ethanleep/robotic-arm/README.md

# Scorebot-ER III
This is my repo for the custom controller I've been designing and assembling for the Scorebot-ER III.
All files here are to be considered a work in progress as they are far from perfect.

The main serial controlled code is robotic_arm_main.ino while the main hard coded code is Custom_movement.ino
