ethanleep/robotic-arm/box files/README.txt

These are the Autodesk Inventor part and assembly files for the controller housing
