ethanleep/robotic-arm/(list of files, cad)

Other CAD files:
box files/Modified Side.ipt
box files/basic side.ipt
box files/bottom.ipt
box files/box assembly.iam
box files/hole side.ipt
box files/other hole side.ipt
box files/top.ipt
