ethanleep/robotic-arm/Testing/README.txt

These are just miscellaneous testing files I use in debugging parts of the arm that are non-functioning or acting up.
