ethanleep/robotic-arm/Individual motor driver v2/Schematic.pdf

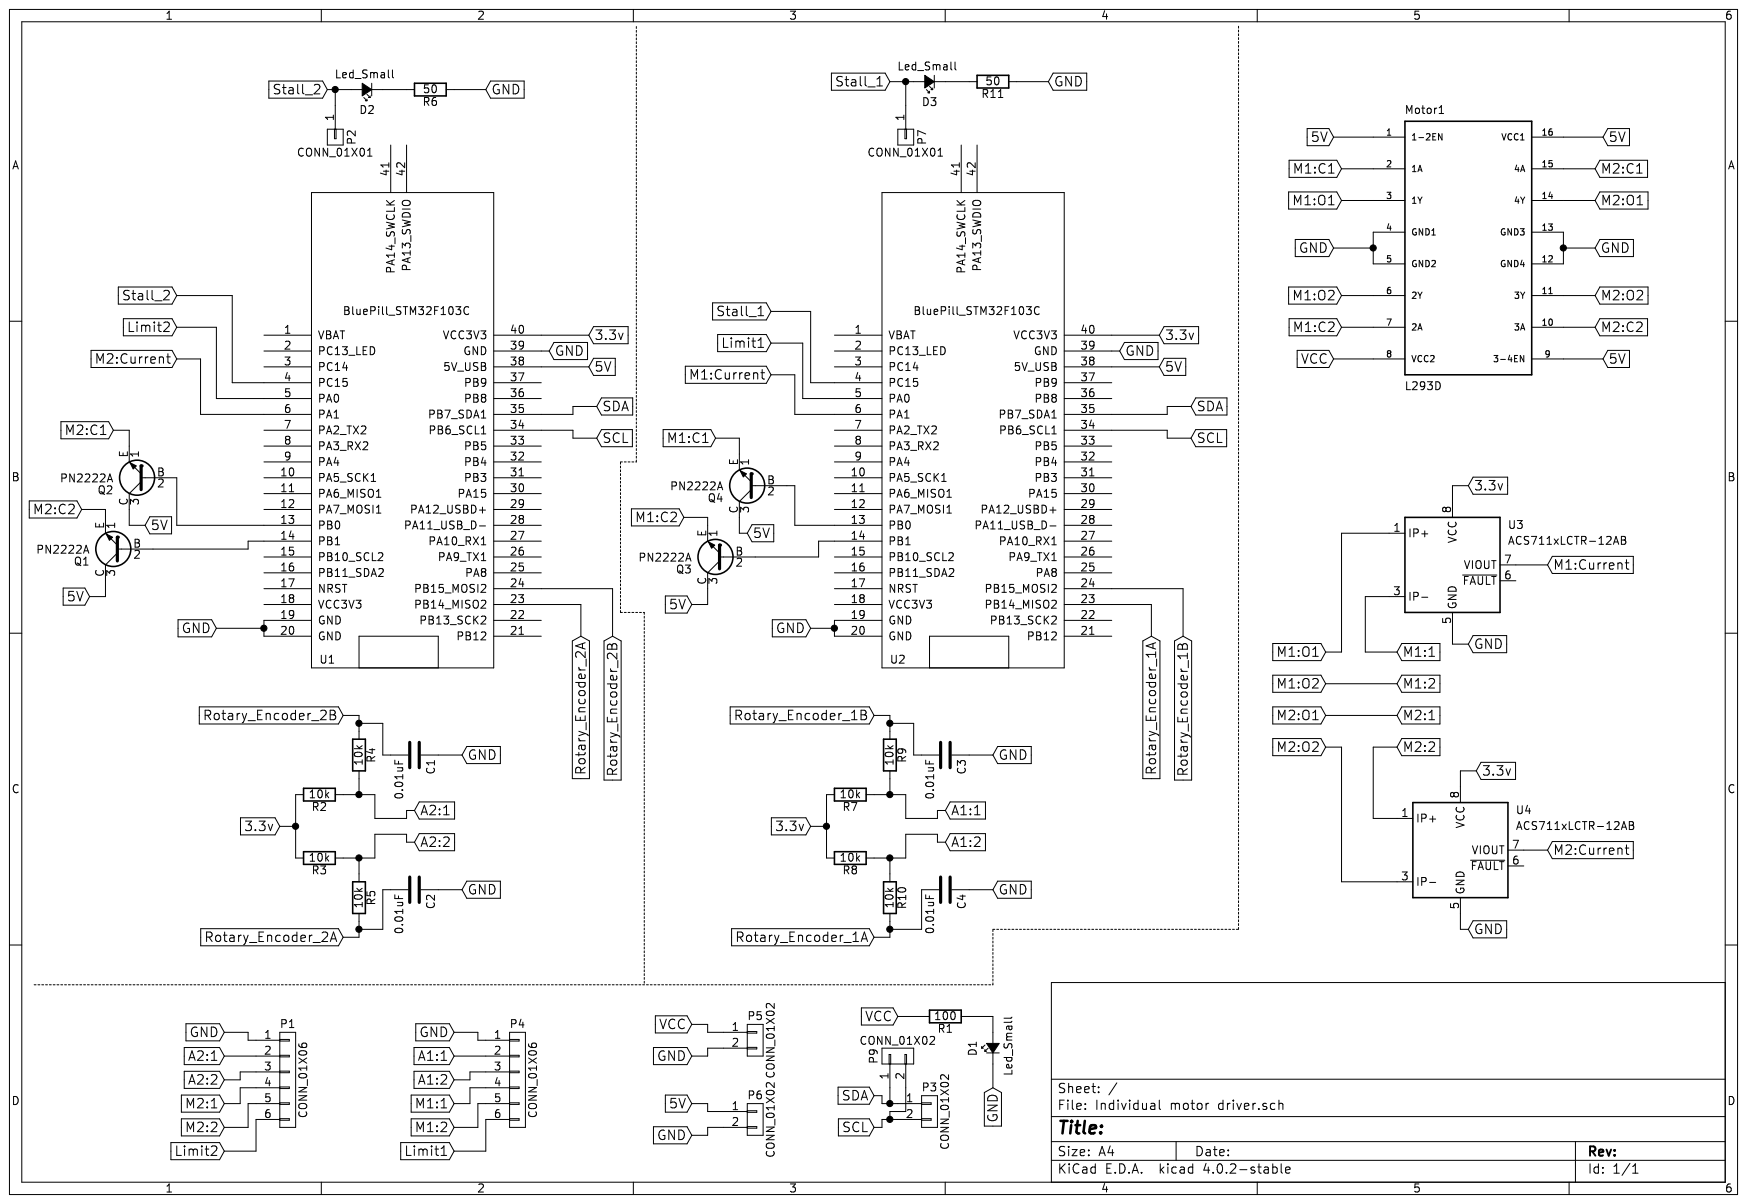
[picture p3: page 1]
