ethanleep/robotic-arm/DB50 Breakout/schematic.pdf

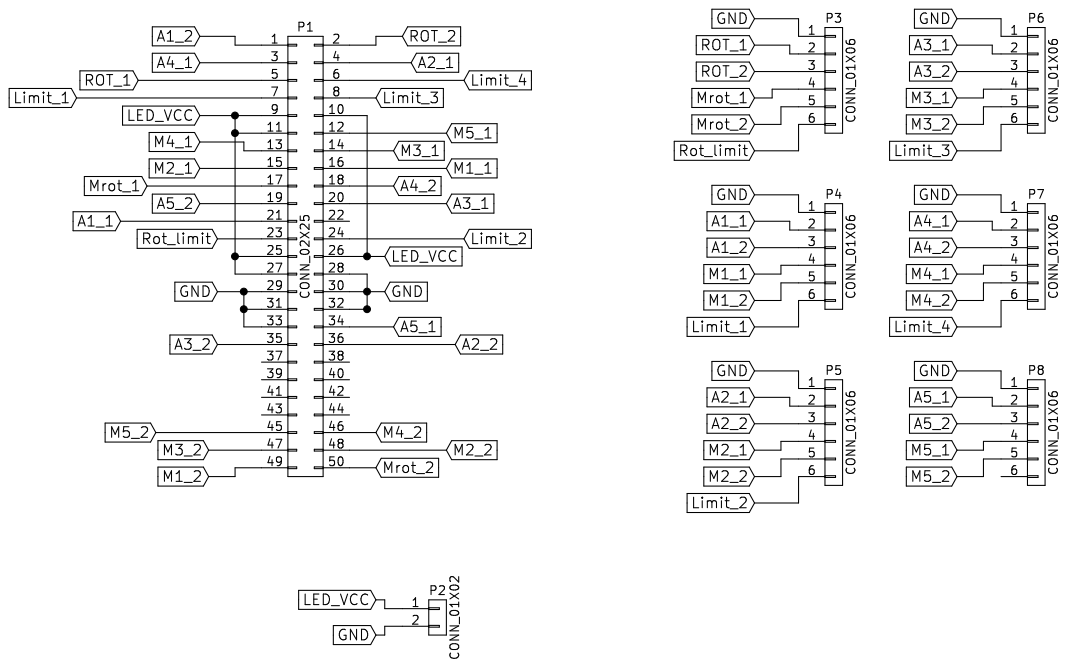
[picture p4: page 1]
