ethanleep/robotic-arm/Individual motor driver v2/Individual motor driver.kicad_pcb

## KiCad design Individual motor driver v2/Individual motor driver.kicad_pcb (2018-12-13)

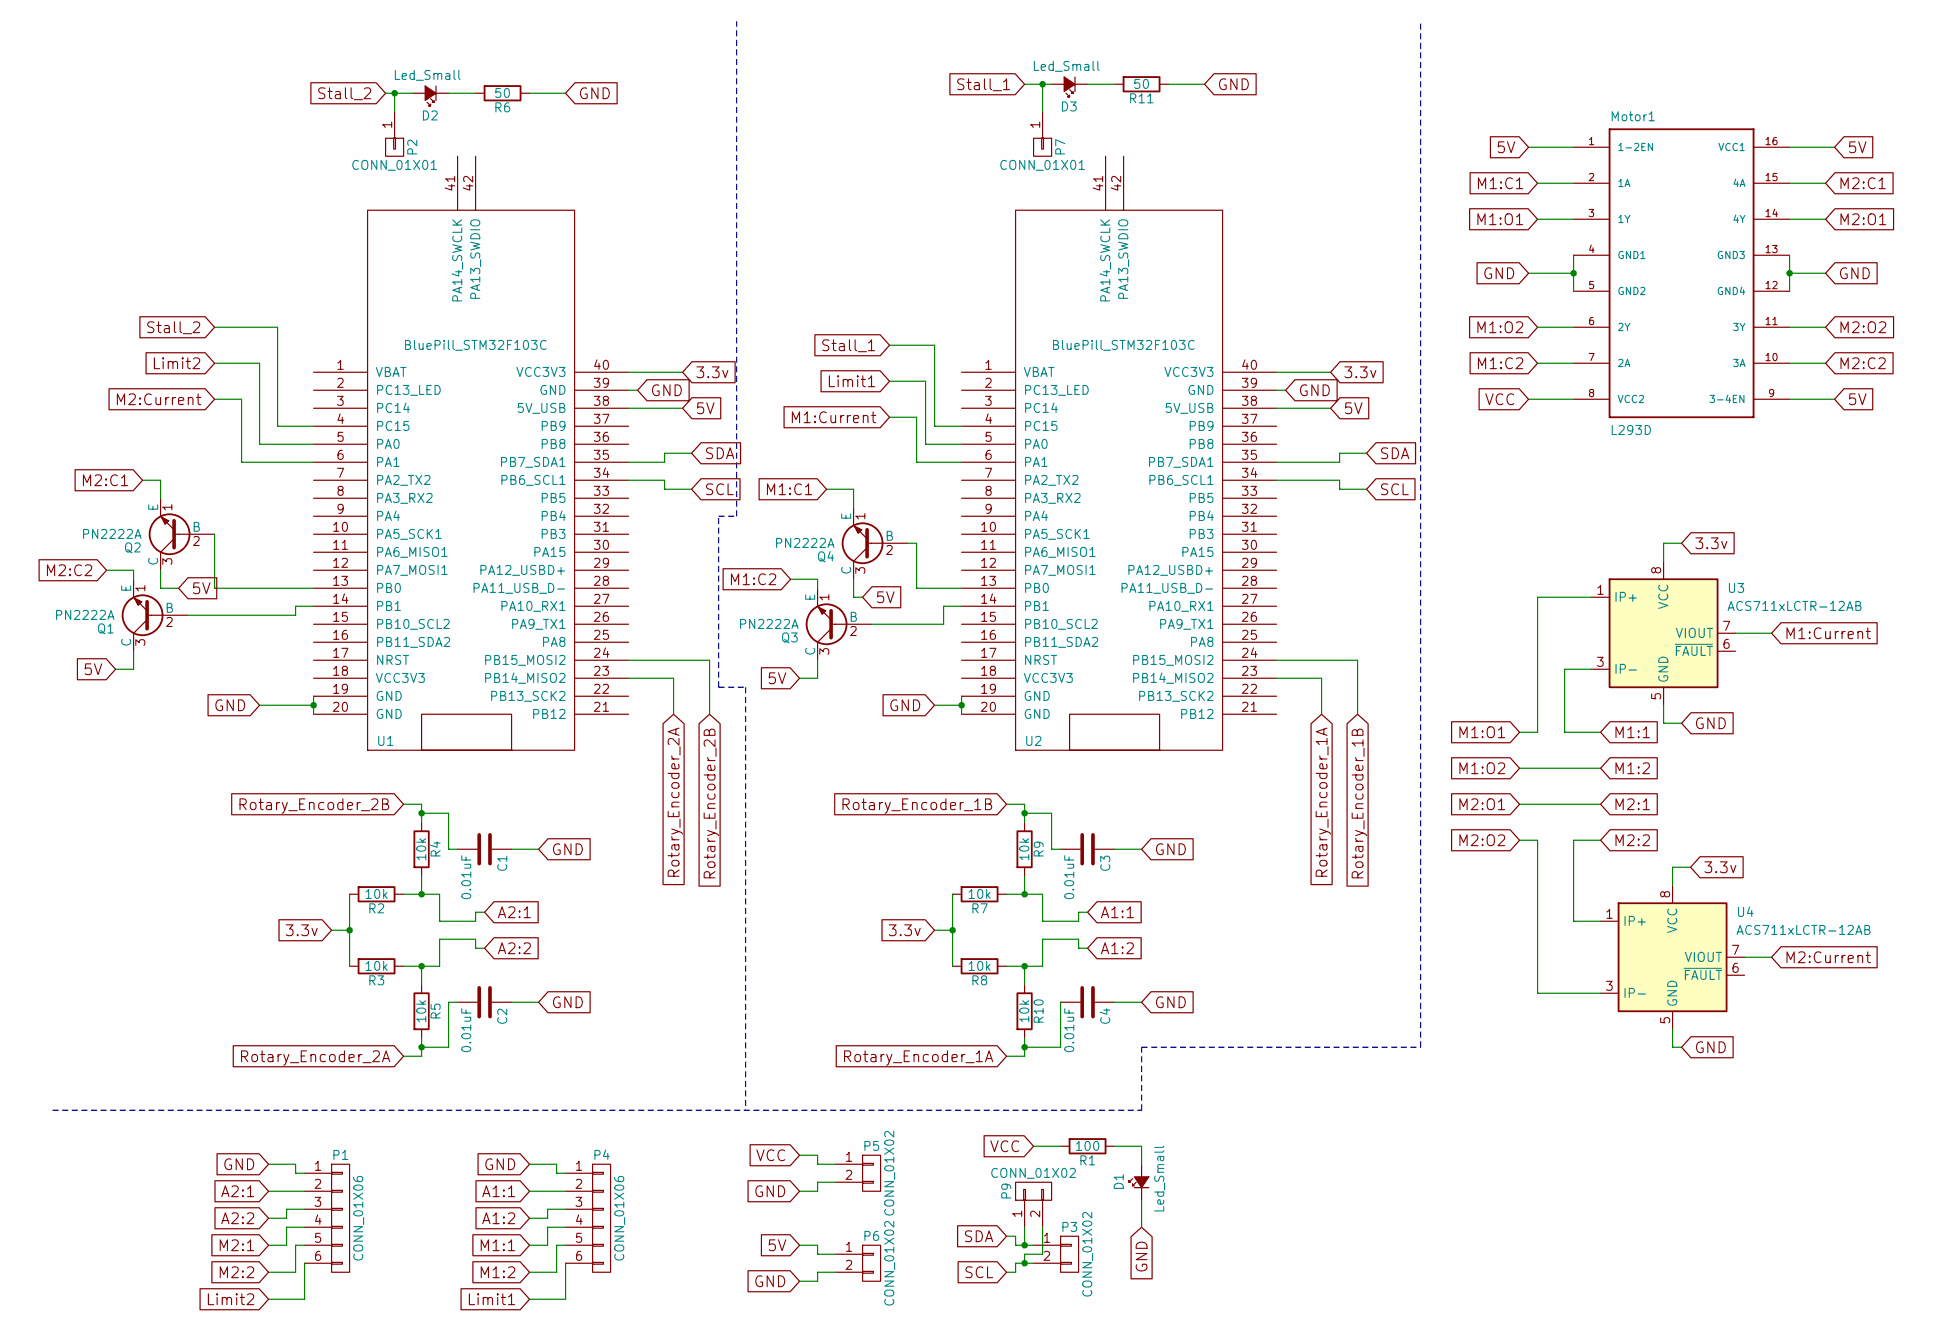
[picture p5: schematic Individual motor driver.sch]

Parts:
C1, C2, C3, C4: 0.01uF; C_Axial_L3.8mm_D2.6mm_P7.50mm_Horizontal
D1, D2, D3: Led_Small; LED_D3.0mm
Motor1: L293D; DIP-16_W7.62mm
P1, P4: CONN_01X06; PinHeader_1x06_P2.54mm_Horizontal
P2, P7: CONN_01X01; PinHeader_1x01_P2.54mm_Vertical
P3, P5, P6, P9: CONN_01X02; PinHeader_1x02_P2.54mm_Vertical
Q1, Q2, Q3, Q4: PN2222A; TO-92_Inline
R1: 100; R_Axial_DIN0207_L6.3mm_D2.5mm_P10.16mm_Horizontal
R2, R3, R4, R5, R7, R8, R9, R10: 10k; R_Axial_DIN0207_L6.3mm_D2.5mm_P10.16mm_Horizontal
R6, R11: 50; R_Axial_DIN0207_L6.3mm_D2.5mm_P10.16mm_Horizontal
U1, U2: BluePill_STM32F103C
U3, U4: ACS711xLCTR-12AB; SOIC-8_3.9x4.9mm_P1.27mm

Connections:
3.3v: R2.2, R3.2, R7.2, R8.2, U1.40 (VCC3V3), U2.40 (VCC3V3), U3.8 (VCC), U4.8 (VCC)
5V: Motor1.1 (1-2EN), Motor1.9 (3-4EN), Motor1.16 (VCC1), P6.1, Q1.3 (C), Q2.3 (C), Q3.3 (C), Q4.3 (C), U1.38 (5V_USB), U2.38 (5V_USB)
A1:1: P4.2, R7.1, R9.2
A1:2: P4.3, R8.1, R10.1
A2:1: P1.2, R2.1, R4.2
A2:2: P1.3, R3.1, R5.1
GND: C1.1, C2.1, C3.1, C4.1, D1.1 (K), Motor1.4 (GND1), Motor1.5 (GND2), Motor1.12 (GND4), Motor1.13 (GND3), P1.1, P4.1, P5.2, P6.2, R6.1, R11.1, U1.19 (GND), U1.20 (GND), U1.39 (GND), U2.19 (GND), U2.20 (GND), U2.39 (GND), U3.5 (GND), U4.5 (GND)
Limit1: P4.6, U2.5 (PA0)
Limit2: P1.6, U1.5 (PA0)
M1:1: P4.4, U3.3 (IP-), U3.4 (IP-); also elsewhere on the board
M1:2: Motor1.6 (2Y), P4.5
M1:C1: Motor1.2 (1A), Q4.1 (E)
M1:C2: Motor1.7 (2A), Q3.1 (E)
M1:Current: U2.6 (PA1), U3.7 (VIOUT)
M1:O1: Motor1.3 (1Y), U3.1 (IP+), U3.2 (IP+); also elsewhere on the board
M2:1: Motor1.14 (4Y), P1.4
M2:2: P1.5, U4.1 (IP+), U4.2 (IP+); also elsewhere on the board
M2:C1: Motor1.15 (4A), Q2.1 (E)
M2:C2: Motor1.10 (3A), Q1.1 (E)
M2:Current: U1.6 (PA1), U4.7 (VIOUT)
M2:O2: Motor1.11 (3Y), U4.3 (IP-), U4.4 (IP-); also elsewhere on the board
unnamed: D1.2 (A), R1.1
unnamed: D2.1 (K), R6.2
unnamed: D3.1 (K), R11.2
unnamed: Q1.2 (B), U1.14 (PB1)
unnamed: Q2.2 (B), U1.13 (PB0)
unnamed: Q3.2 (B), U2.14 (PB1)
unnamed: Q4.2 (B), U2.13 (PB0)
Rotary_Encoder_1A: C4.2, R10.2, U2.23 (PB14_MISO2)
Rotary_Encoder_1B: C3.2, R9.1, U2.24 (PB15_MOSI2)
Rotary_Encoder_2A: C2.2, R5.2, U1.23 (PB14_MISO2)
Rotary_Encoder_2B: C1.2, R4.1, U1.24 (PB15_MOSI2)
SCL: P3.2, P9.2, U1.34 (PB6_SCL1), U2.34 (PB6_SCL1)
SDA: P3.1, P9.1, U1.35 (PB7_SDA1), U2.35 (PB7_SDA1)
Stall_1: D3.2 (A), P7.1, U2.4 (PC15)
Stall_2: D2.2 (A), P2.1, U1.4 (PC15)
VCC: Motor1.8 (VCC2), P5.1, R1.2

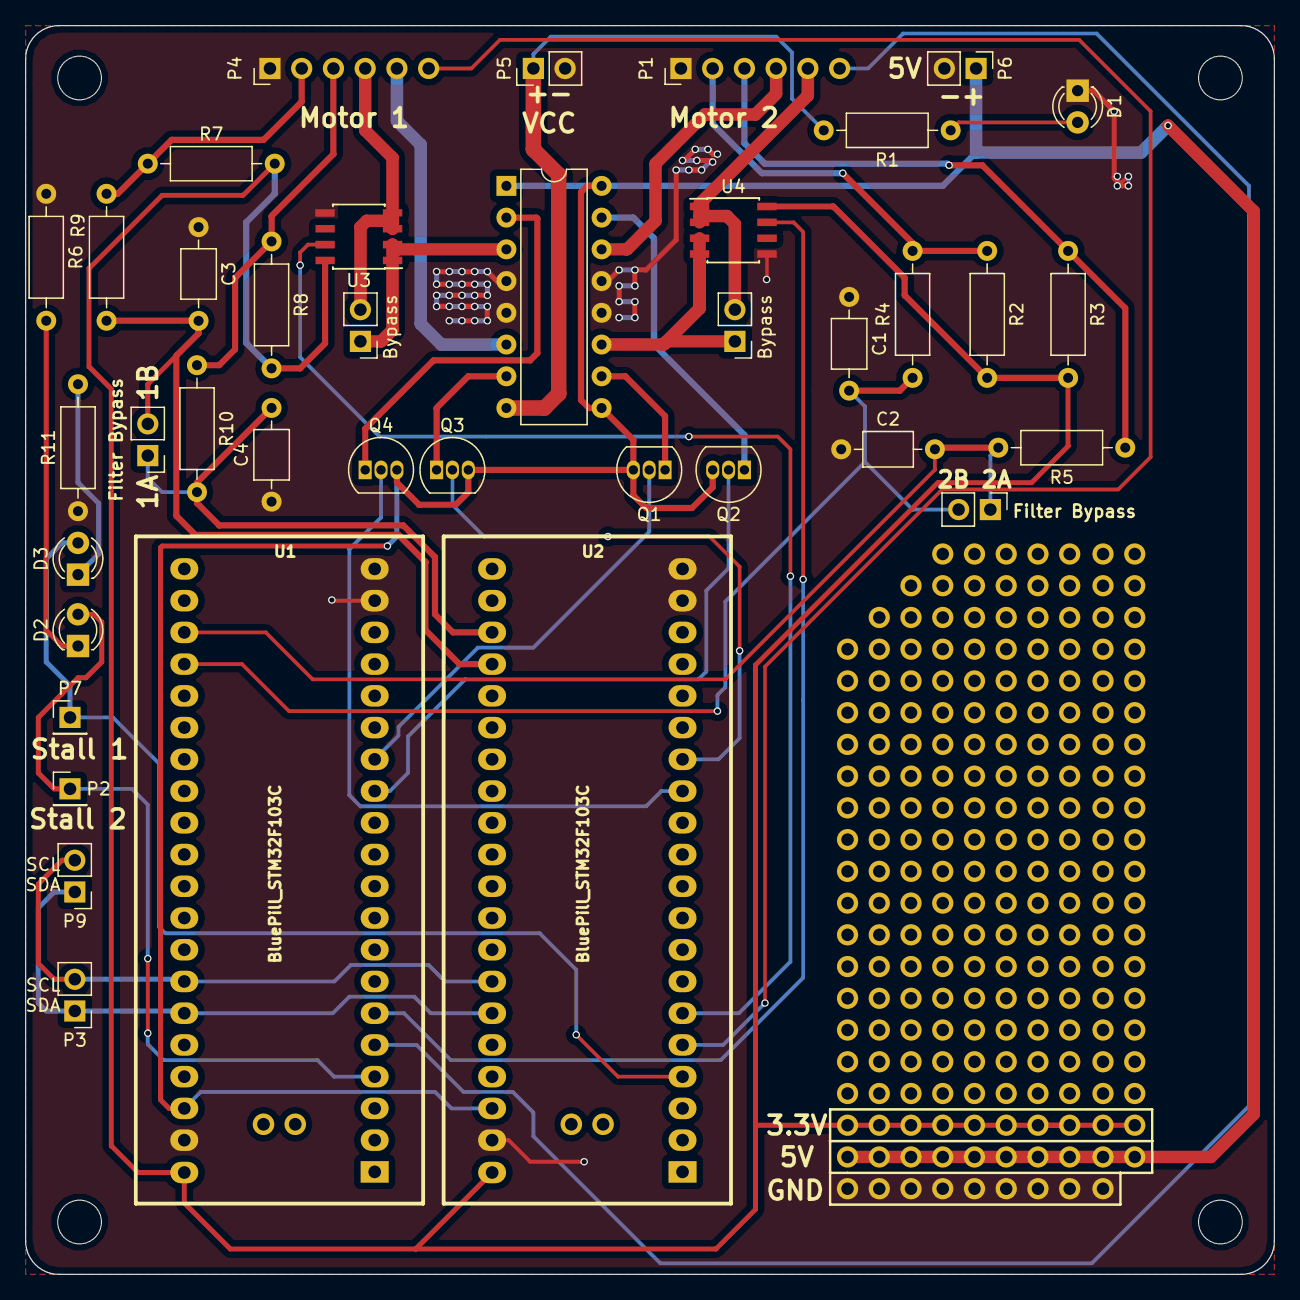
[picture p6: board Individual motor driver.kicad_pcb from above]

Board: 2 copper layers, 99.9 x 99.9 mm, 37 parts (0 on the bottom side), 37 nets.

Other parts of the board:
Bypass: PinHeader_1x02_P2.54mm_Vertical
Bypass#2: PinHeader_1x02_P2.54mm_Vertical

Their connections:
M1:1: Bypass.2; also elsewhere on the board
M1:O1: Bypass.1; also elsewhere on the board
M2:2: Bypass#2.2; also elsewhere on the board
M2:O2: Bypass#2.1; also elsewhere on the board
