ethanleep/robotic-arm/DB50 Breakout/DB50 Breakout.kicad_pcb

## KiCad design DB50 Breakout/DB50 Breakout.kicad_pcb (2018-12-11)

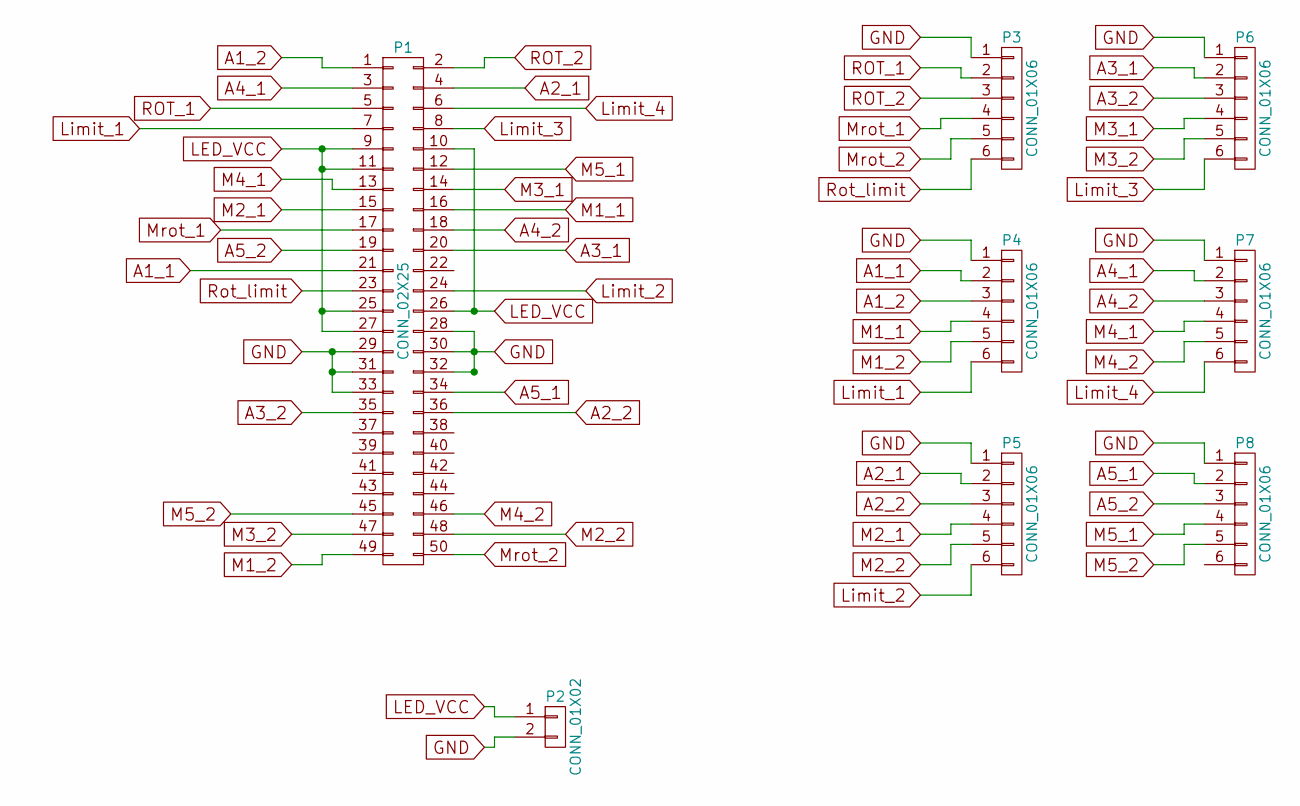
[picture p7: schematic DB50 Breakout.sch]

Parts:
P1: CONN_02X25; Dsub_50
P2: CONN_01X02; PinHeader_1x02_P2.54mm_Vertical
P3, P4, P5, P6, P7, P8: CONN_01X06; PinHeader_1x06_P2.54mm_Vertical

Connections:
A1_1: P1.21, P4.2
A1_2: P1.1, P4.3
A2_1: P1.4, P5.2
A2_2: P1.36, P5.3
A3_1: P1.20, P6.2
A3_2: P1.35, P6.3
A4_1: P1.3, P7.2
A4_2: P1.18, P7.3
A5_1: P1.34, P8.2
A5_2: P1.19, P8.3
GND: P1.28, P1.29, P1.30, P1.31, P1.32, P1.33, P2.2, P3.1, P4.1, P5.1, P6.1, P7.1, P8.1
LED_VCC: P1.9, P1.10, P1.11, P1.25, P1.26, P1.27, P2.1
Limit_1: P1.7, P4.6
Limit_2: P1.24, P5.6
Limit_3: P1.8, P6.6
Limit_4: P1.6, P7.6
M1_1: P1.16, P4.4
M1_2: P1.49, P4.5
M2_1: P1.15, P5.4
M2_2: P1.48, P5.5
M3_1: P1.14, P6.4
M3_2: P1.47, P6.5
M4_1: P1.13, P7.4
M4_2: P1.46, P7.5
M5_1: P1.12, P8.4
M5_2: P1.45, P8.5
Mrot_1: P1.17, P3.4
Mrot_2: P1.50, P3.5
ROT_1: P1.5, P3.2
ROT_2: P1.2, P3.3
Rot_limit: P1.23, P3.6

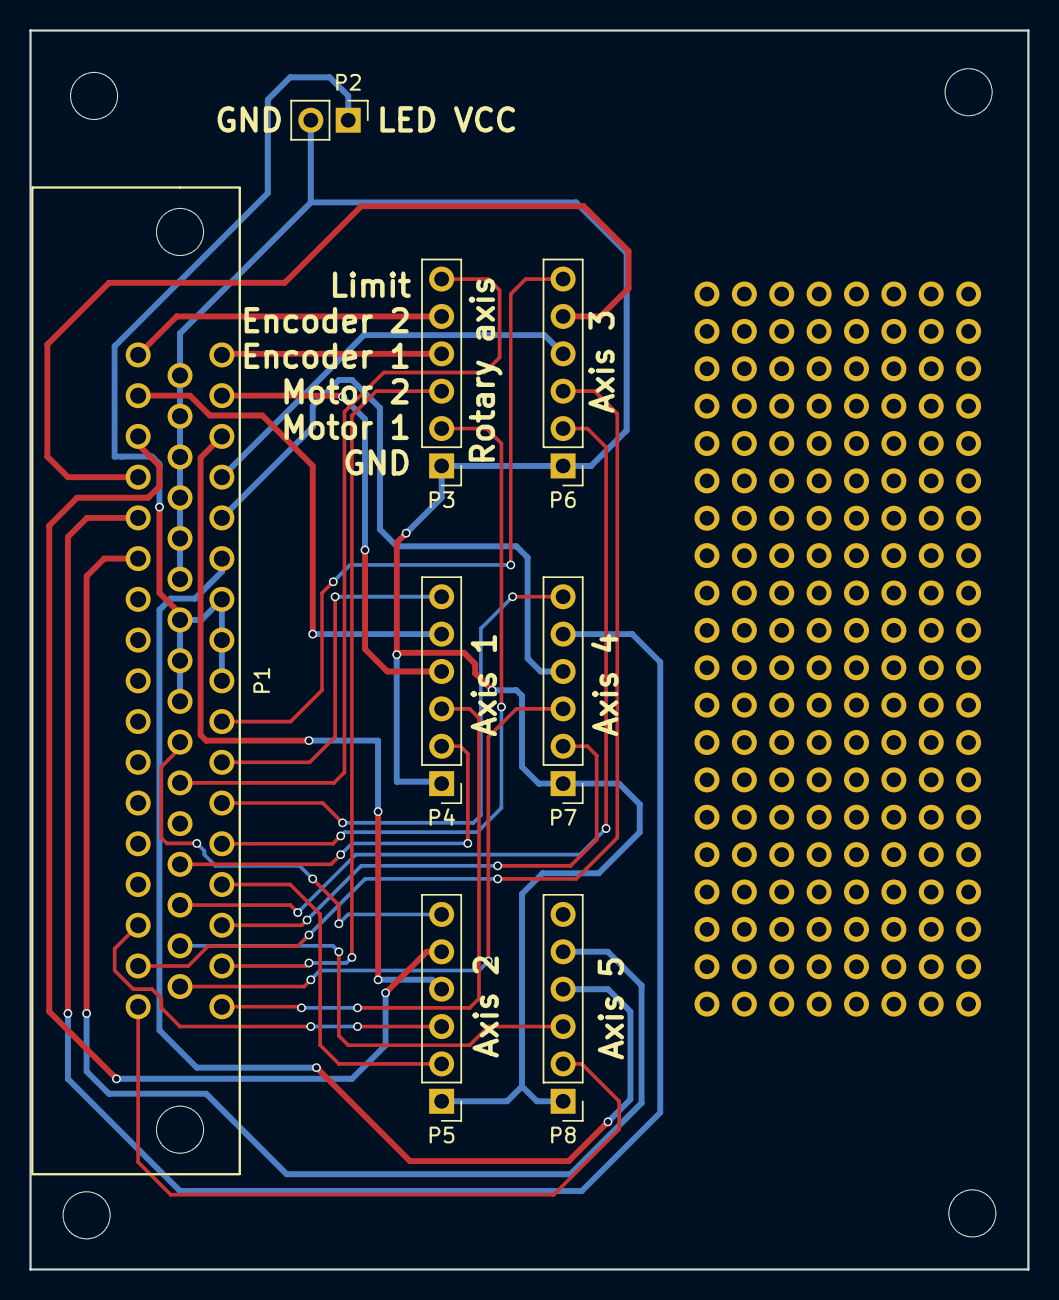
[picture p8: board DB50 Breakout.kicad_pcb from above]

Board: 2 copper layers, 67.8 x 84.2 mm, 8 parts (0 on the bottom side), 31 nets.
