ethanleep/robotic-arm/(commit log)

2018-10-30 Added Controller Housing files
    [Modified Side.ipt, basic side.ipt, bottom.ipt, box assembly.iam, hole side.ipt, other hole side.ipt, top.ipt]
2018-10-31 Added PCB files O
    [Robotic arm.kicad_pcb, Robotic arm.sch]
2018-11-01 New controller
    [Individual motor driver.kicad_pcb, Individual motor driver.sch]
2018-11-05 Further work on the new controller PCB
2018-11-06 PCB file update
2018-11-14 New PCB project
    [Individual motor driver.sch]
2018-11-14 Update files
    [Individual motor driver.kicad_pcb]
2018-11-15 Finished routing and improved some design flaws
    [Individual motor driver.kicad_pcb]
2018-11-15 PCB updates
    [Individual motor driver.kicad_pcb, Individual motor driver.sch]
2018-11-16 Misc. Changes to PCB
    [Individual motor driver.kicad_pcb]
2018-11-20 Fixed rotary encoder filter
    [Individual motor driver.kicad_pcb, Individual motor driver.sch]
2018-11-29 Added DB50 breakout schematic
    [DB50 Breakout.kicad_pcb, DB50 Breakout.sch]
2018-11-30 Started routing on DB50 breakout
    [DB50 Breakout.kicad_pcb, DB50 Breakout.sch]
2018-12-03 Updated DB50 breakout
    [DB50 Breakout.kicad_pcb]
2018-12-05 New version of board file
    [Individual motor driver.kicad_pcb, Individual motor driver.sch]
2018-12-06 Continued routing on board
    [Individual motor driver.kicad_pcb]
2018-12-06 Finished routing and added silkscreen
    [Individual motor driver.kicad_pcb]
2018-12-06 Updated V2 files
    [Individual motor driver.kicad_pcb]
2018-12-07 Updated DB50 breakout size
    [DB50 Breakout.kicad_pcb]
2018-12-10 Updated breakout
    [DB50 Breakout.kicad_pcb]
2018-12-11 Added dimensions and gerber files
    [DB50 Breakout.kicad_pcb, Individual motor driver.kicad_pcb]
2018-12-13 Made small changes to the V2 board and regenerated gerbers
    [Individual motor driver-B.Cu.gbl, Individual motor driver-B.Mask.gbs, Individual motor driver-B.SilkS.gbo, Individual motor driver-Edge.Cuts.gm1, Individual motor driver-F.Cu.gtl, Individual motor driver-F.Mask.gts, Individual motor driver-F.SilkS.gto, Individual motor driver.drl]
2018-12-13 Forgot to save files before uploading
    [Individual motor driver.kicad_pcb]
2019-01-21 Started on STM32 master/slave code
2019-01-25 Updated STM32 slave and master code
